sladekdavid1-rgb/cnc-pendant-ugs-rp2040/00_obrazky/DPS_A_rozmisteni.png

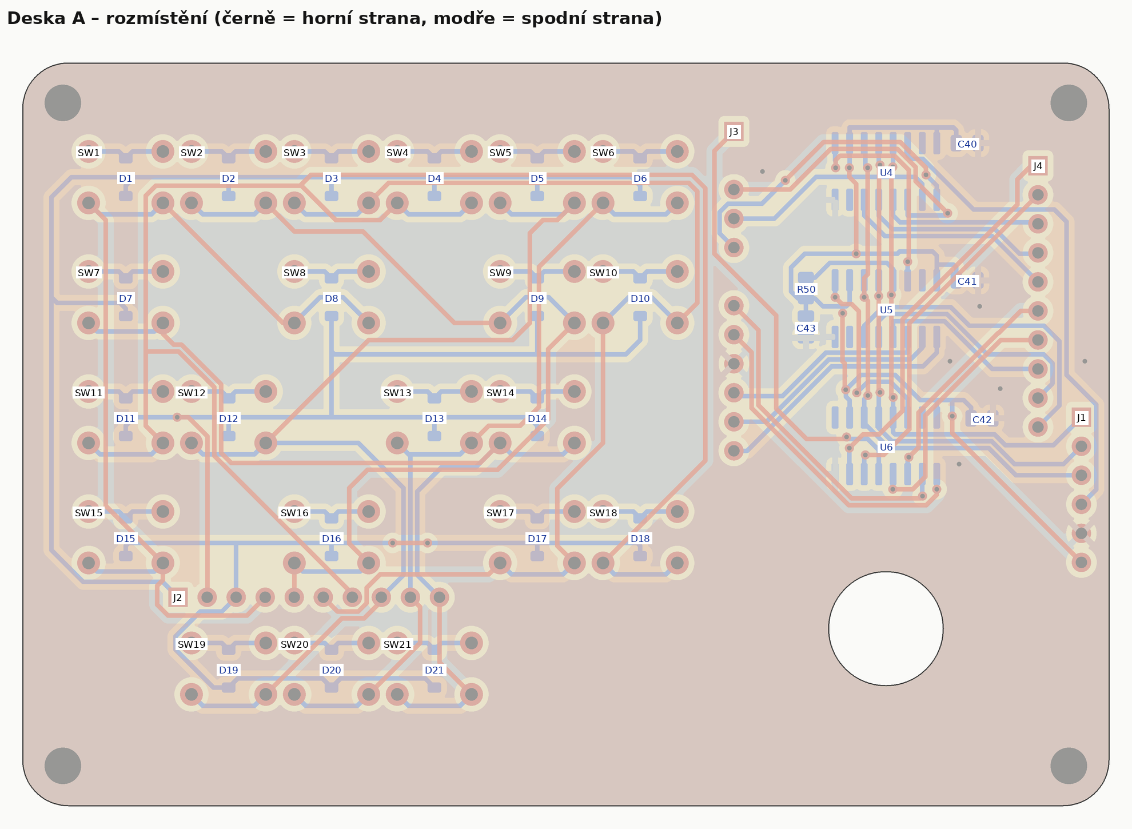
00_obrazky/DPS_A_rozmisteni.png
