sladekdavid1-rgb/cnc-pendant-ugs-rp2040/00_obrazky/DPS_A_spodni_med.png

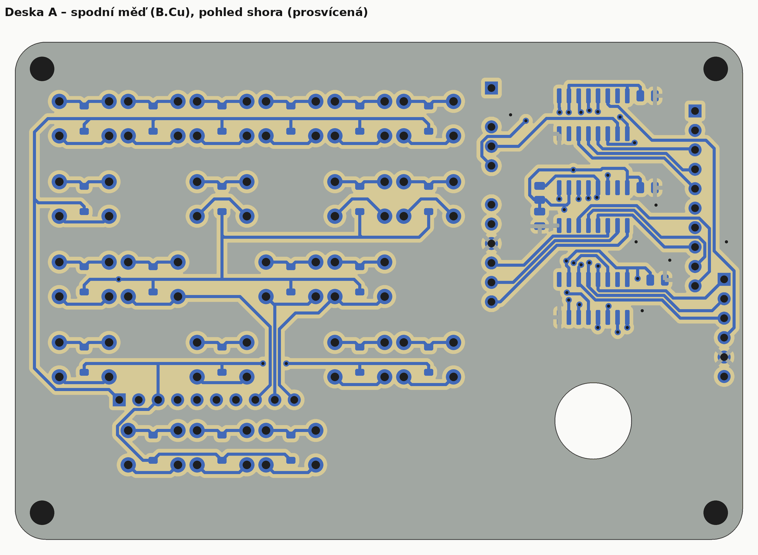
00_obrazky/DPS_A_spodni_med.png
