sladekdavid1-rgb/cnc-pendant-ugs-rp2040/00_obrazky/DPS_B_rozmisteni.png

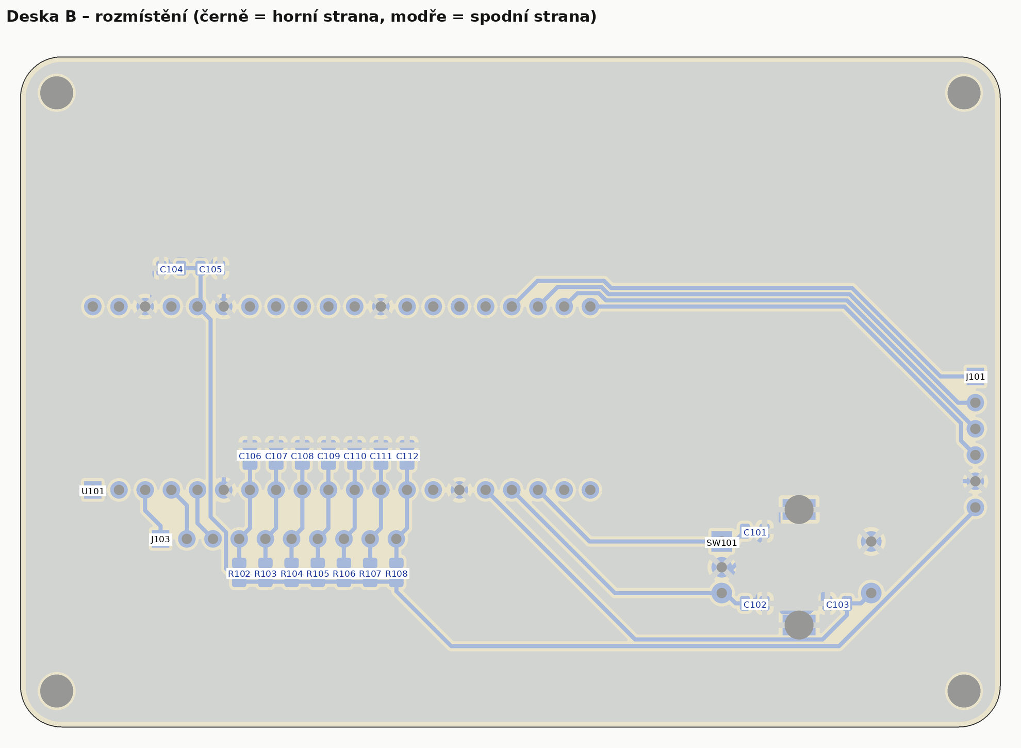
00_obrazky/DPS_B_rozmisteni.png
