sladekdavid1-rgb/cnc-pendant-ugs-rp2040/00_obrazky/fotky/foto_deska_A_spodni.jpg

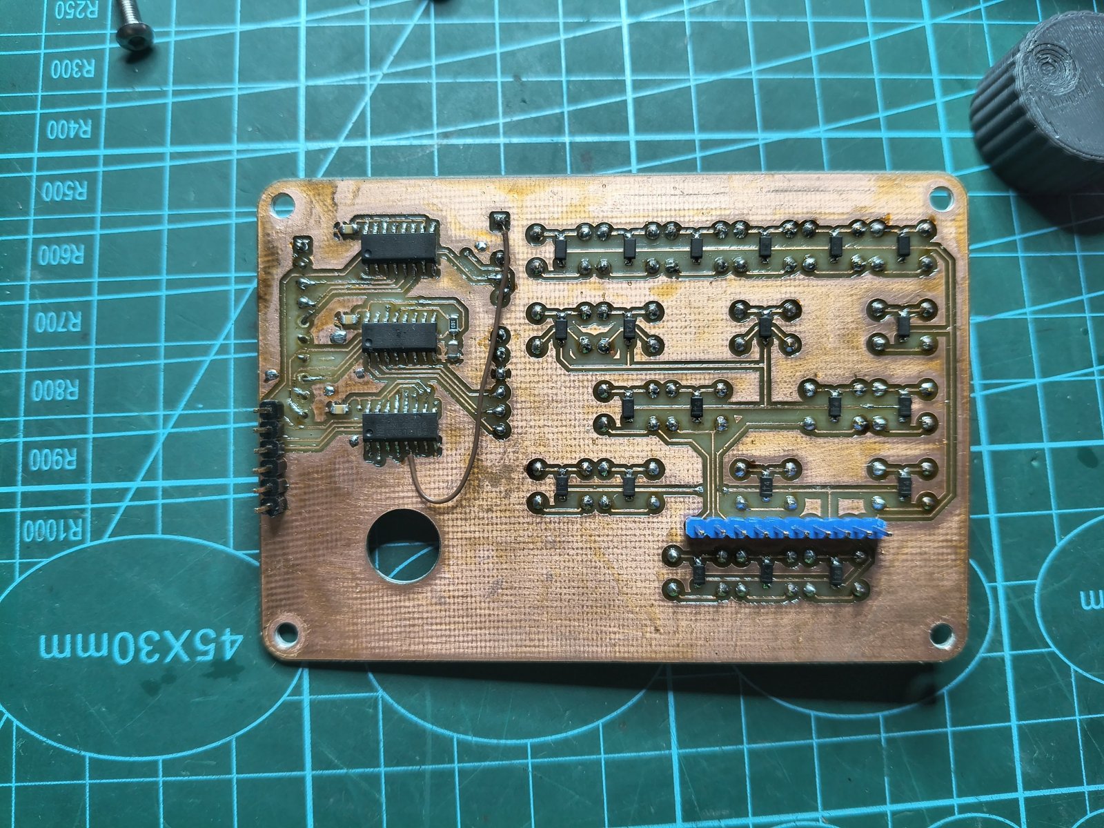
00_obrazky/fotky/foto_deska_A_spodni.jpg
