sladekdavid1-rgb/cnc-pendant-ugs-rp2040/00_obrazky/fotky/foto_hotovy_pendant_sikmo.jpg

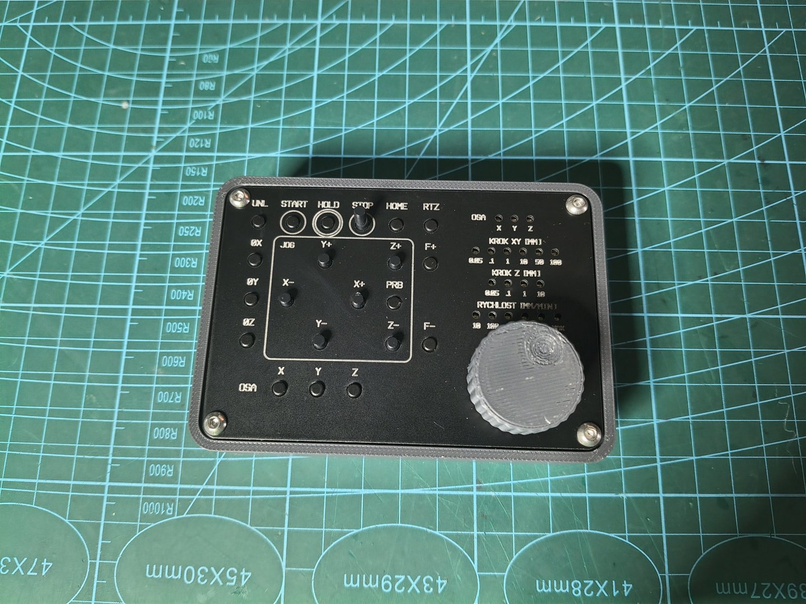
00_obrazky/fotky/foto_hotovy_pendant_sikmo.jpg
