sladekdavid1-rgb/cnc-pendant-ugs-rp2040/00_obrazky/sestava_rez.png

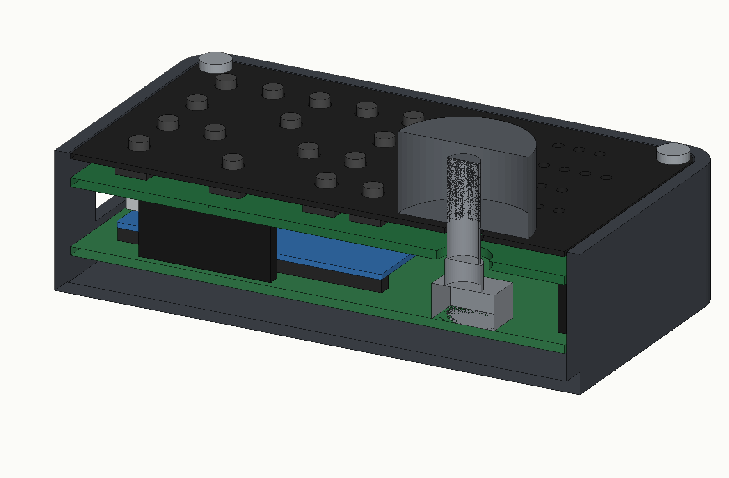
00_obrazky/sestava_rez.png
