sladekdavid1-rgb/cnc-pendant-ugs-rp2040/03_pripravek_MDF/pripravek_DPS_3018.png

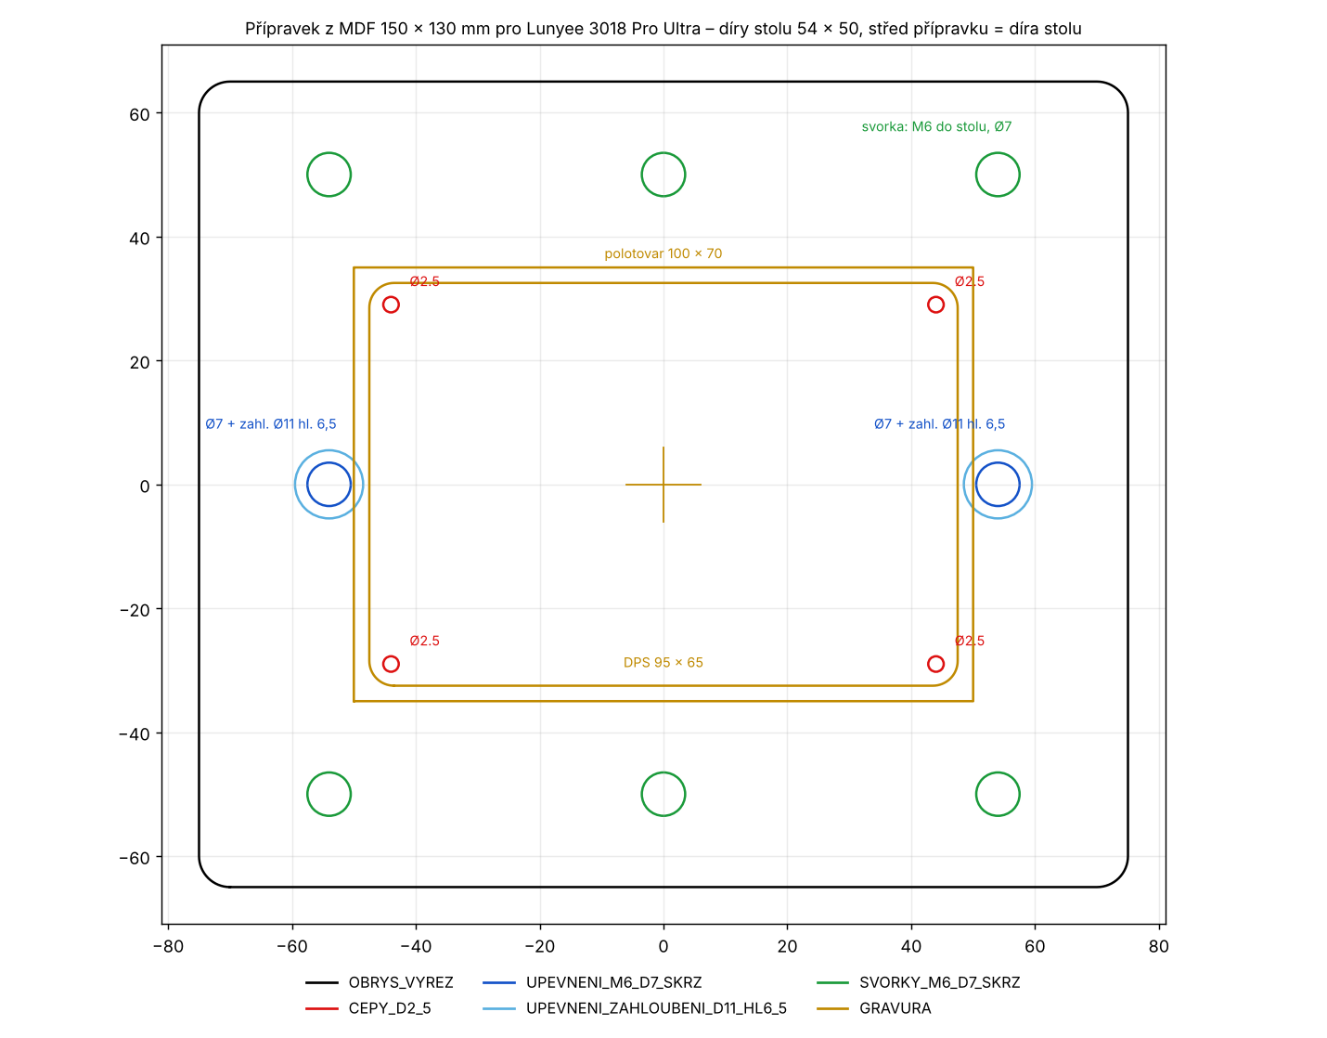
03_pripravek_MDF/pripravek_DPS_3018.png
