sladekdavid1-rgb/cnc-pendant-ugs-rp2040/04_panel_cela/2_laser_paleni/G-kody_bez_LightBurnu/pendant_panel_laser.png

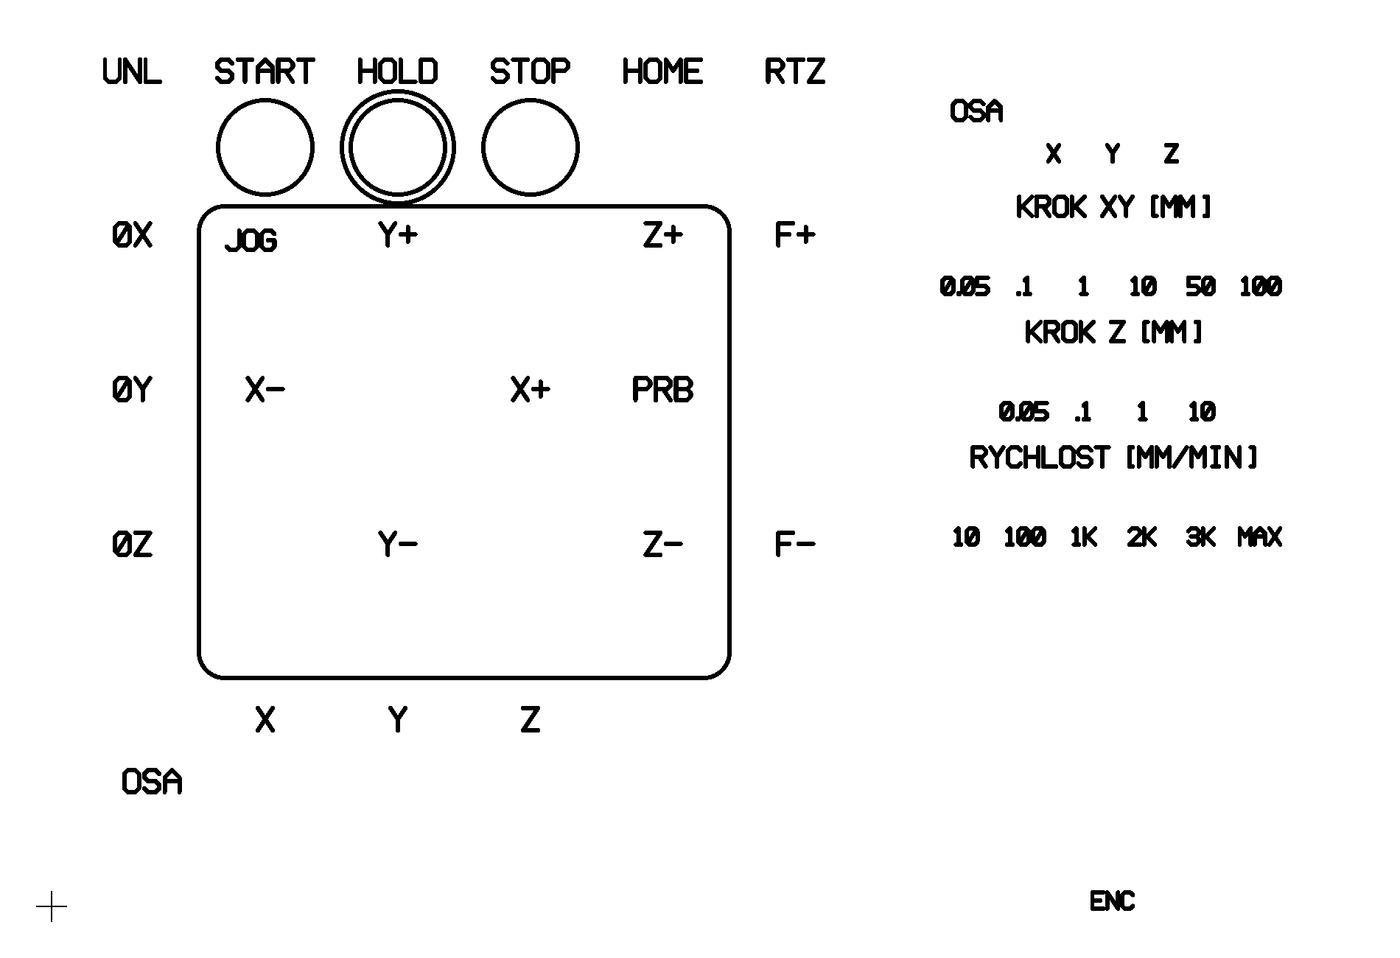
04_panel_cela/2_laser_paleni/G-kody_bez_LightBurnu/pendant_panel_laser.png
