sladekdavid1-rgb/cnc-pendant-ugs-rp2040/04_panel_cela/2_laser_paleni/podklad_nahled.png

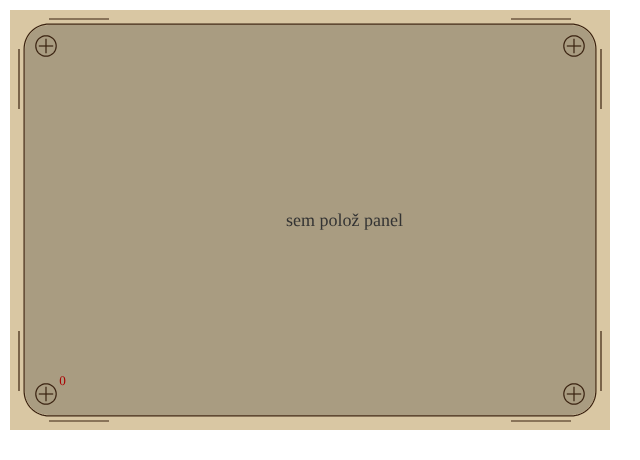
04_panel_cela/2_laser_paleni/podklad_nahled.png
