sladekdavid1-rgb/cnc-pendant-ugs-rp2040/04_panel_cela/3_alternativa_MDF_kapsa/kapsa_panel_MDF_nahled.png

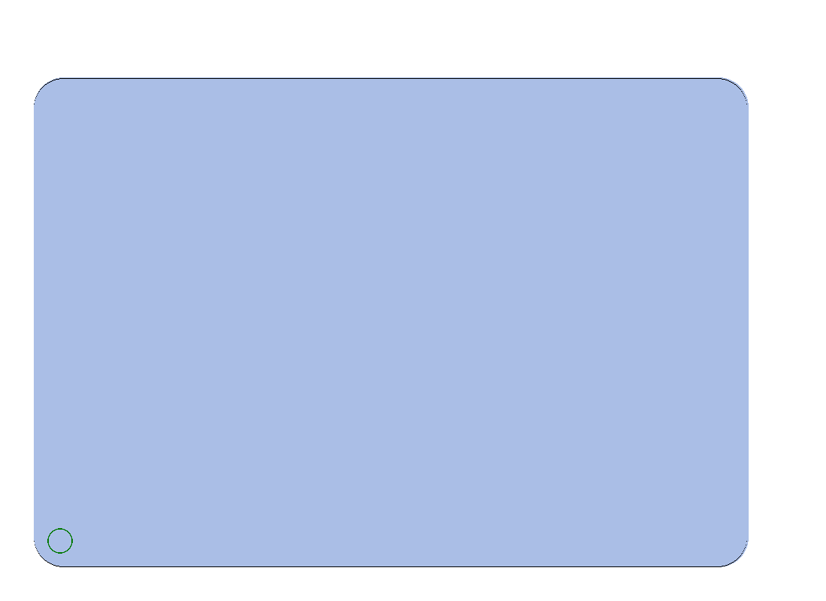
04_panel_cela/3_alternativa_MDF_kapsa/kapsa_panel_MDF_nahled.png
