sladekdavid1-rgb/cnc-pendant-ugs-rp2040/05_krabicka_3D_tisk/knoflik/knoflik_nahled.png

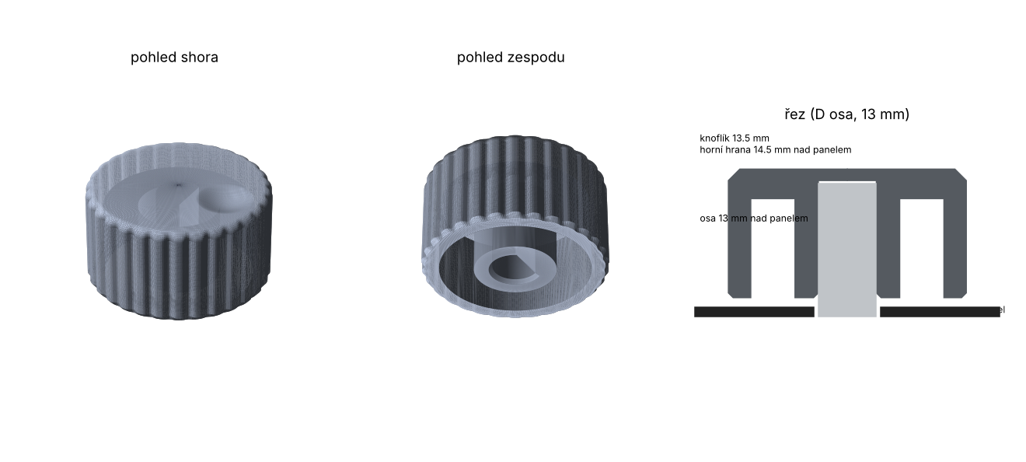
05_krabicka_3D_tisk/knoflik/knoflik_nahled.png
