sladekdavid1-rgb/cnc-pendant-ugs-rp2040/03_pripravek_MDF/pripravek_DPS_3018.dxf

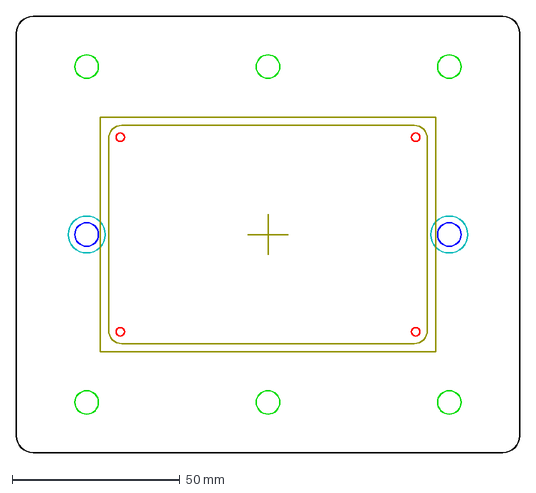
[picture p35: CAD file, 2026-10-19]
03_pripravek_MDF/pripravek_DPS_3018.dxf
150.0 x 130.0 mm
