sladekdavid1-rgb/cnc-pendant-ugs-rp2040/04_panel_cela/vykresy_DXF/pendant_panel_otvory.dxf

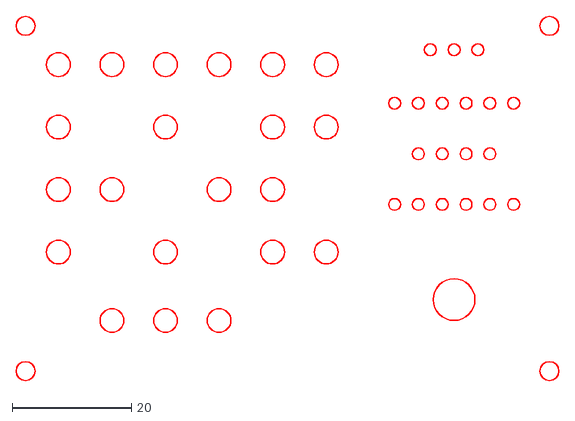
[picture p36: CAD file, 2026-10-19]
04_panel_cela/vykresy_DXF/pendant_panel_otvory.dxf
91.2 x 61.2
