sladekdavid1-rgb/cnc-pendant-ugs-rp2040/05_krabicka_3D_tisk/CNCpendant.step

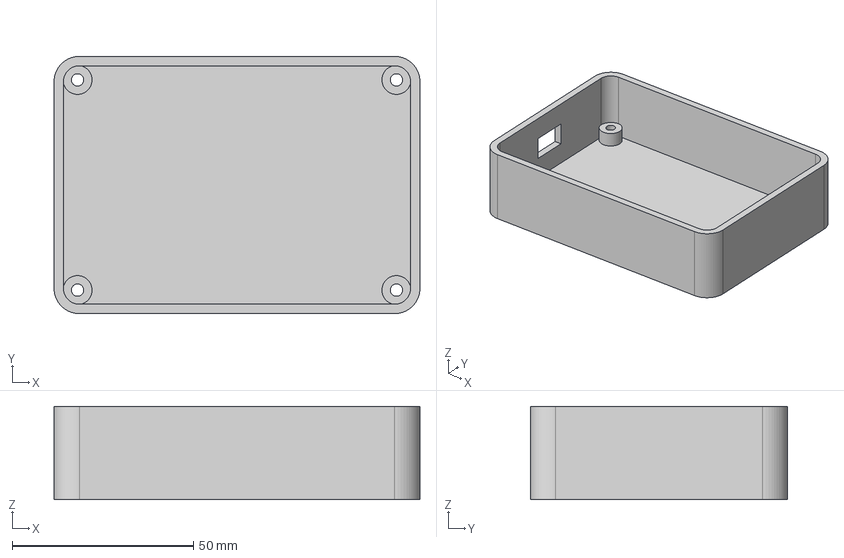
[picture p37: CAD file, 2026-10-19]
05_krabicka_3D_tisk/CNCpendant.step
101.0 x 71.0 x 25.7 mm
