sladekdavid1-rgb/cnc-pendant-ugs-rp2040/05_krabicka_3D_tisk/distancni_sloupky/distance_A-panel_3_5mm.stl

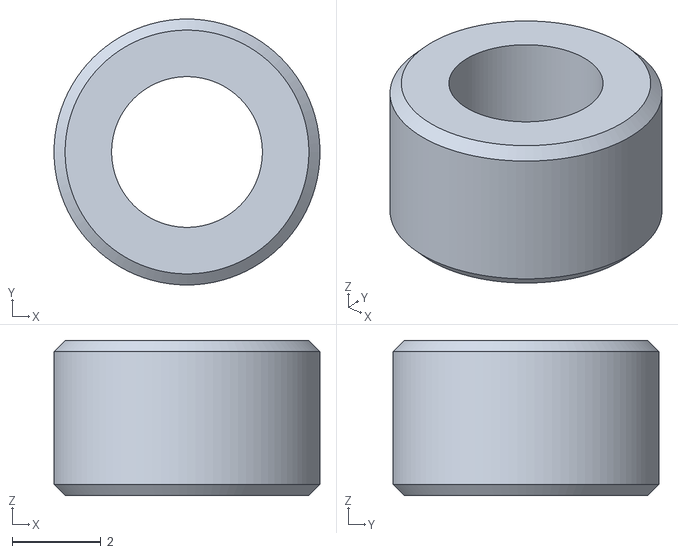
[picture p38: CAD file, 2026-10-19]
05_krabicka_3D_tisk/distancni_sloupky/distance_A-panel_3_5mm.stl
6.00 x 6.00 x 3.50
