sladekdavid1-rgb/cnc-pendant-ugs-rp2040/05_krabicka_3D_tisk/distancni_sloupky/distance_sada_5+5ks.stl

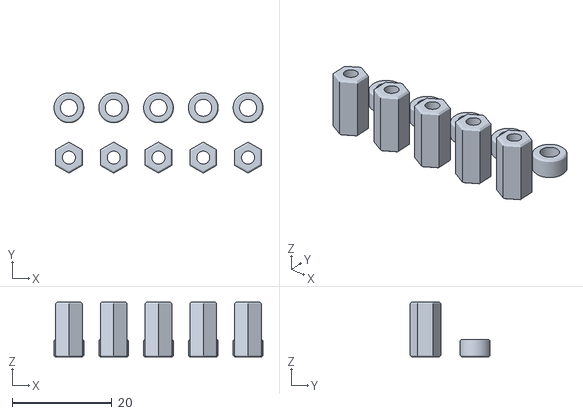
[picture p41: CAD file, 2026-10-19]
05_krabicka_3D_tisk/distancni_sloupky/distance_sada_5+5ks.stl
42.0 x 16.1 x 11.0
