sladekdavid1-rgb/cnc-pendant-ugs-rp2040/05_krabicka_3D_tisk/knoflik/knoflik_vroubkovana_osa_12mm_nad_panelem.stl

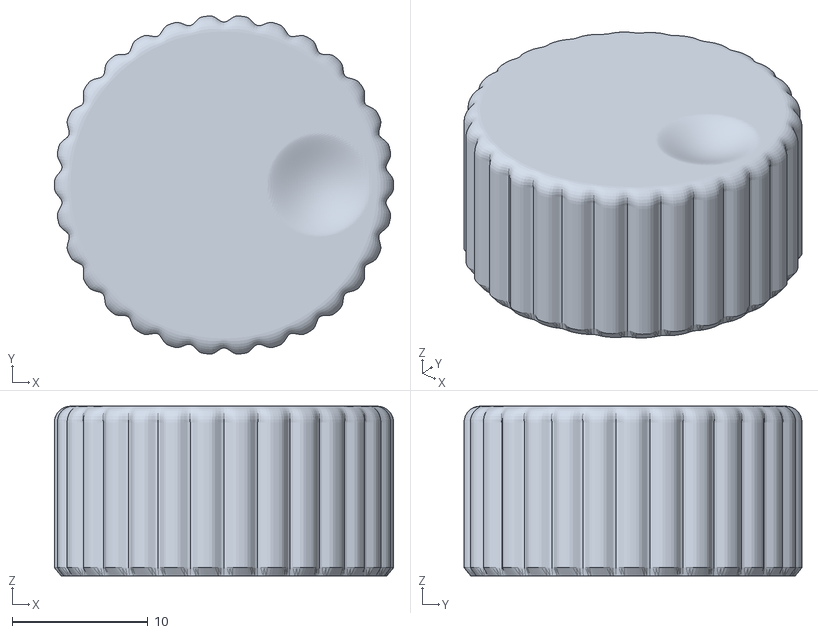
[picture p42: CAD file, 2026-10-19]
05_krabicka_3D_tisk/knoflik/knoflik_vroubkovana_osa_12mm_nad_panelem.stl
25.0 x 24.9 x 12.5
