sladekdavid1-rgb/cnc-pendant-ugs-rp2040/04_panel_cela/vykresy_DXF/pendant_panel_obrys.dxf

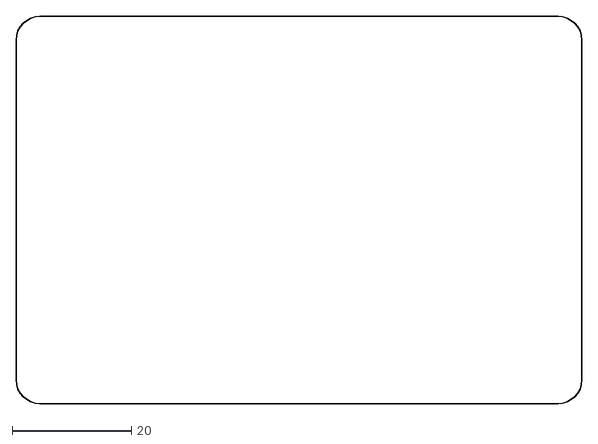
[picture p43: CAD file, 2026-10-19]
04_panel_cela/vykresy_DXF/pendant_panel_obrys.dxf
95.0 x 65.0
