sladekdavid1-rgb/cnc-pendant-ugs-rp2040/05_krabicka_3D_tisk/distancni_sloupky/distance_B-A_11mm_SESTIHRAN_5_5.stl

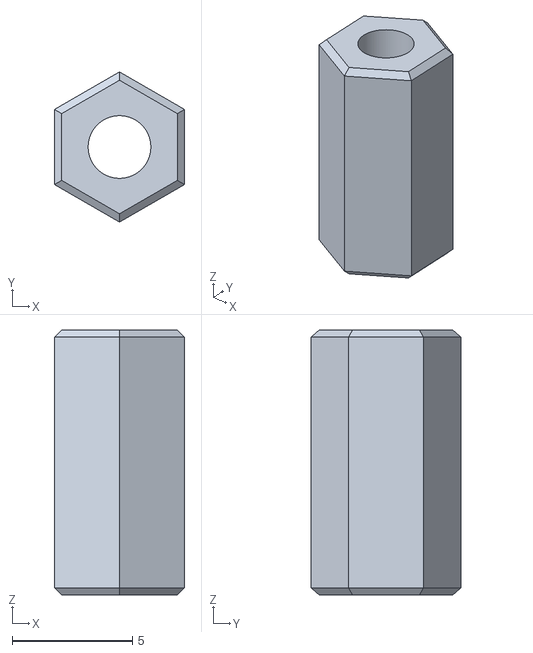
[picture p44: CAD file, 2026-10-19]
05_krabicka_3D_tisk/distancni_sloupky/distance_B-A_11mm_SESTIHRAN_5_5.stl
5.40 x 6.24 x 11.0
