sladekdavid1-rgb/cnc-pendant-ugs-rp2040/04_panel_cela/vykresy_DXF/pendant_panel_gravura.dxf

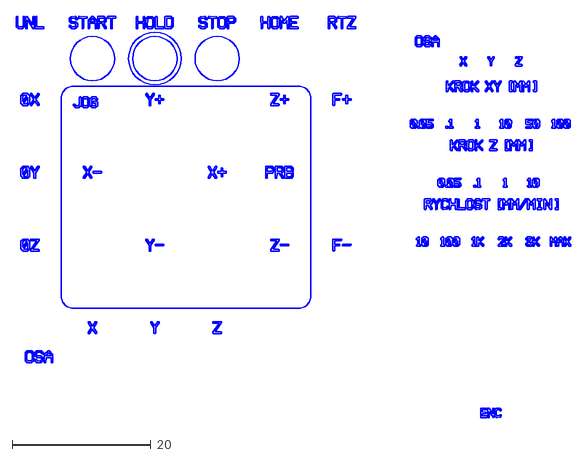
[picture p46: CAD file, 2026-10-19]
04_panel_cela/vykresy_DXF/pendant_panel_gravura.dxf
80.0 x 57.9
