sladekdavid1-rgb/cnc-pendant-ugs-rp2040/(list of files, cad)

Other CAD files:
05_krabicka_3D_tisk/knoflik/knoflik_vroubkovana_osa_9mm_nad_panelem.stl
05_krabicka_3D_tisk/knoflik/knoflik_D_osa_13mm_nad_panelem.stl
05_krabicka_3D_tisk/knoflik/knoflik_D_osa_12mm_nad_panelem.stl
05_krabicka_3D_tisk/knoflik/knoflik_vroubkovana_osa_14mm_nad_panelem.stl
05_krabicka_3D_tisk/knoflik/knoflik_D_osa_10mm_nad_panelem.stl
05_krabicka_3D_tisk/knoflik/knoflik_D_osa_11mm_nad_panelem.stl
05_krabicka_3D_tisk/CNCpendant.3mf
