sladekdavid1-rgb/cnc-pendant-ugs-rp2040/01_DPS_KiCad/pendant_B_spodni/pendant_B_spodni.kicad_pcb

## KiCad design 01_DPS_KiCad/pendant_B_spodni/pendant_B_spodni.kicad_pcb (2026-10-19)

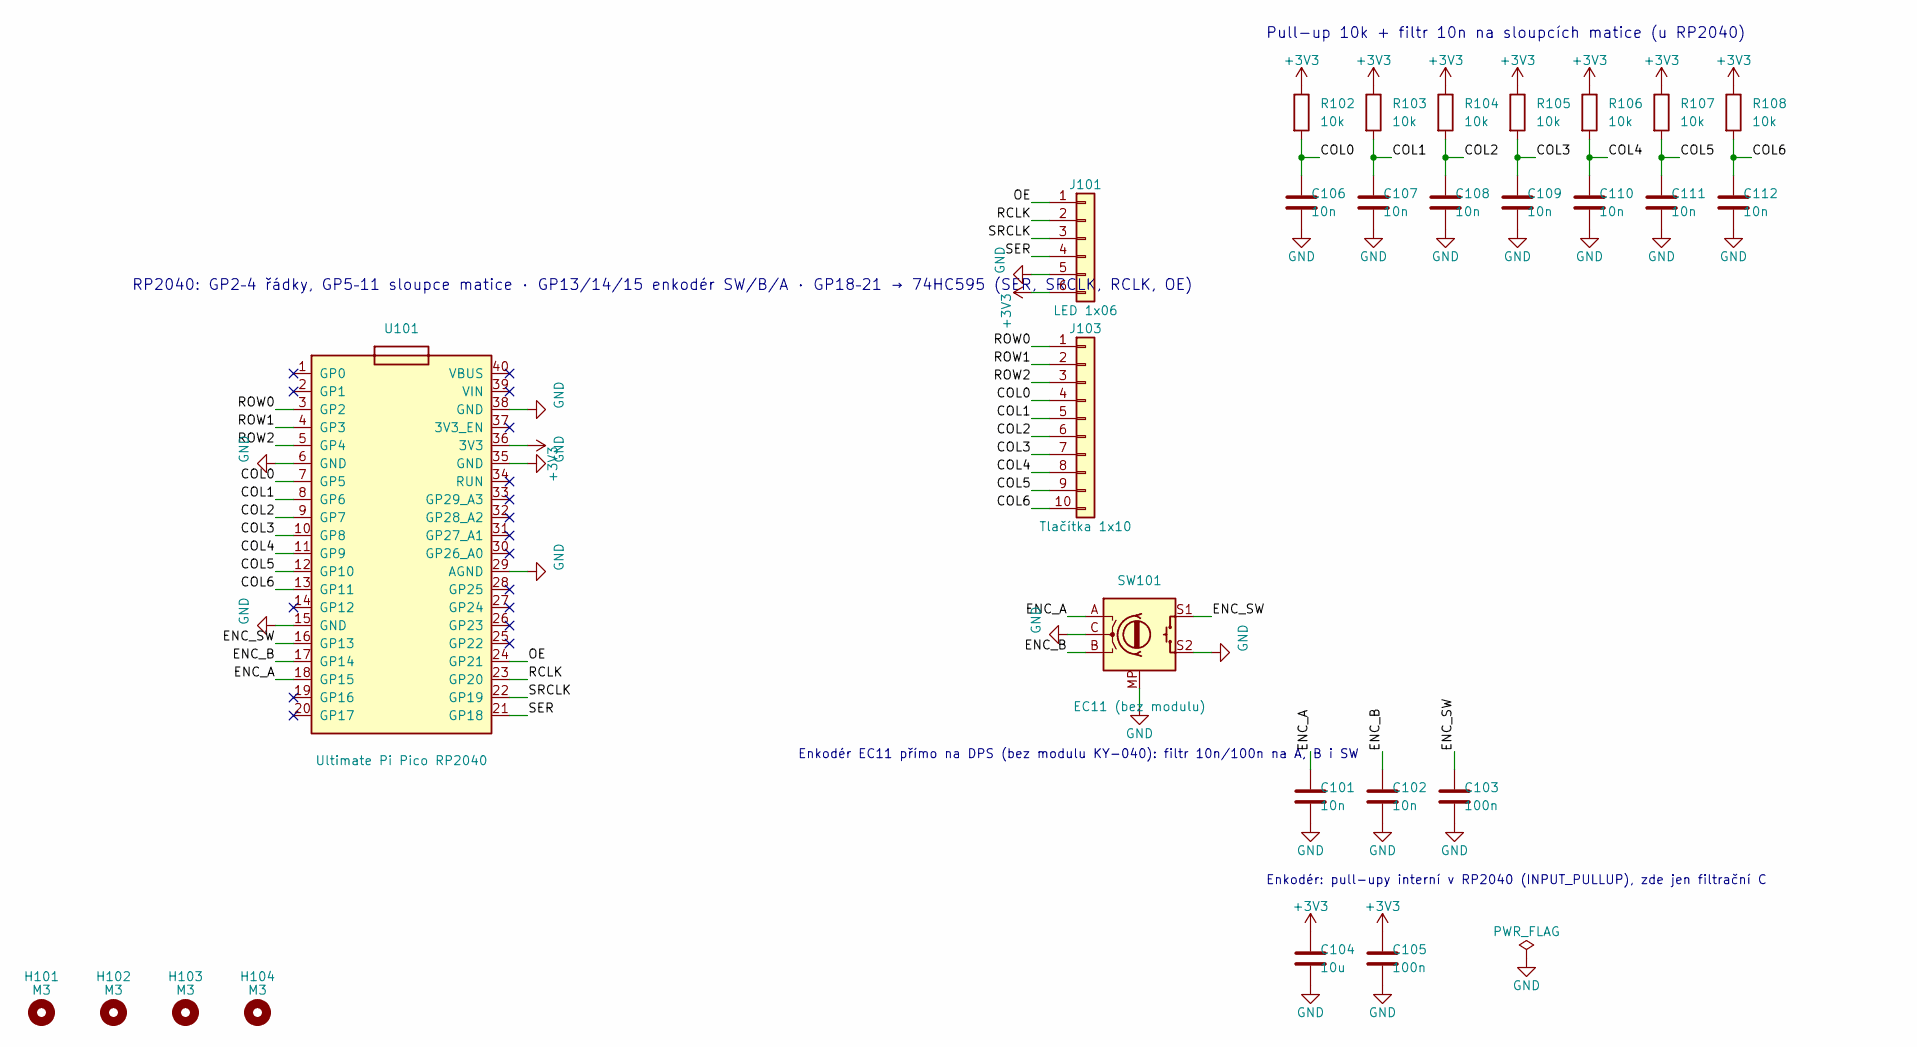
[picture p51: schematic pendant_B_spodni.kicad_sch, CNC pendant – spodní DPS (Ultimate Pi Pico RP2040, enkodér)]

Parts:
C101, C102, C106, C107, C108, C109, C110, C111, C112: 10n; C_0805_2012Metric
C103, C105: 100n; C_0805_2012Metric
C104: 10u; C_0805_2012Metric
H101, H102, H103, H104: M3; MountingHole_3.2mm_M3
J101: LED 1x06; PinHeader_1x06_P2.54mm_Vertical
J103: Tlačítka 1x10; PinHeader_1x10_P2.54mm_Vertical
R102, R103, R104, R105, R106, R107, R108: 10k; R_0805_2012Metric
SW101: EC11 (bez modulu); RotaryEncoder_Alps_EC11E-Switch_Vertical_H20mm
U101: Ultimate Pi Pico RP2040; Ultimate_Pico_2x20_W17.78

Connections:
+3V3: C104.1, C105.1, J101.6, R102.1, R103.1, R104.1, R105.1, R106.1, R107.1, R108.1, U101.36 (3V3)
/COL0: C106.1, J103.4, R102.2, U101.7 (GP5)
/COL1: C107.1, J103.5, R103.2, U101.8 (GP6)
/COL2: C108.1, J103.6, R104.2, U101.9 (GP7)
/COL3: C109.1, J103.7, R105.2, U101.10 (GP8)
/COL4: C110.1, J103.8, R106.2, U101.11 (GP9)
/COL5: C111.1, J103.9, R107.2, U101.12 (GP10)
/COL6: C112.1, J103.10, R108.2, U101.13 (GP11)
/ENC_A: C101.1, SW101.A, U101.18 (GP15)
/ENC_B: C102.1, SW101.B, U101.17 (GP14)
/ENC_SW: C103.1, SW101.S1, U101.16 (GP13)
/OE: J101.1, U101.24 (GP21)
/RCLK: J101.2, U101.23 (GP20)
/ROW0: J103.1, U101.3 (GP2)
/ROW1: J103.2, U101.4 (GP3)
/ROW2: J103.3, U101.5 (GP4)
/SER: J101.4, U101.21 (GP18)
/SRCLK: J101.3, U101.22 (GP19)
GND: C101.2, C102.2, C103.2, C104.2, C105.2, C106.2, C107.2, C108.2, C109.2, C110.2, C111.2, C112.2, J101.5, SW101.C, SW101.MP, SW101.S2, U101.6 (GND), U101.15 (GND), U101.29 (AGND), U101.35 (GND), U101.38 (GND)

Notes on the sheet:
RP2040: GP2–4 řádky, GP5–11 sloupce matice · GP13/14/15 enkodér SW/B/A · GP18–21 → 74HC595 (SER, SRCLK, RCLK, OE)
Pull-up 10k + filtr 10n na sloupcích matice (u RP2040)
Enkodér EC11 přímo na DPS (bez modulu KY-040): filtr 10n/100n na A, B i SW
Enkodér: pull-upy interní v RP2040 (INPUT_PULLUP), zde jen filtrační C

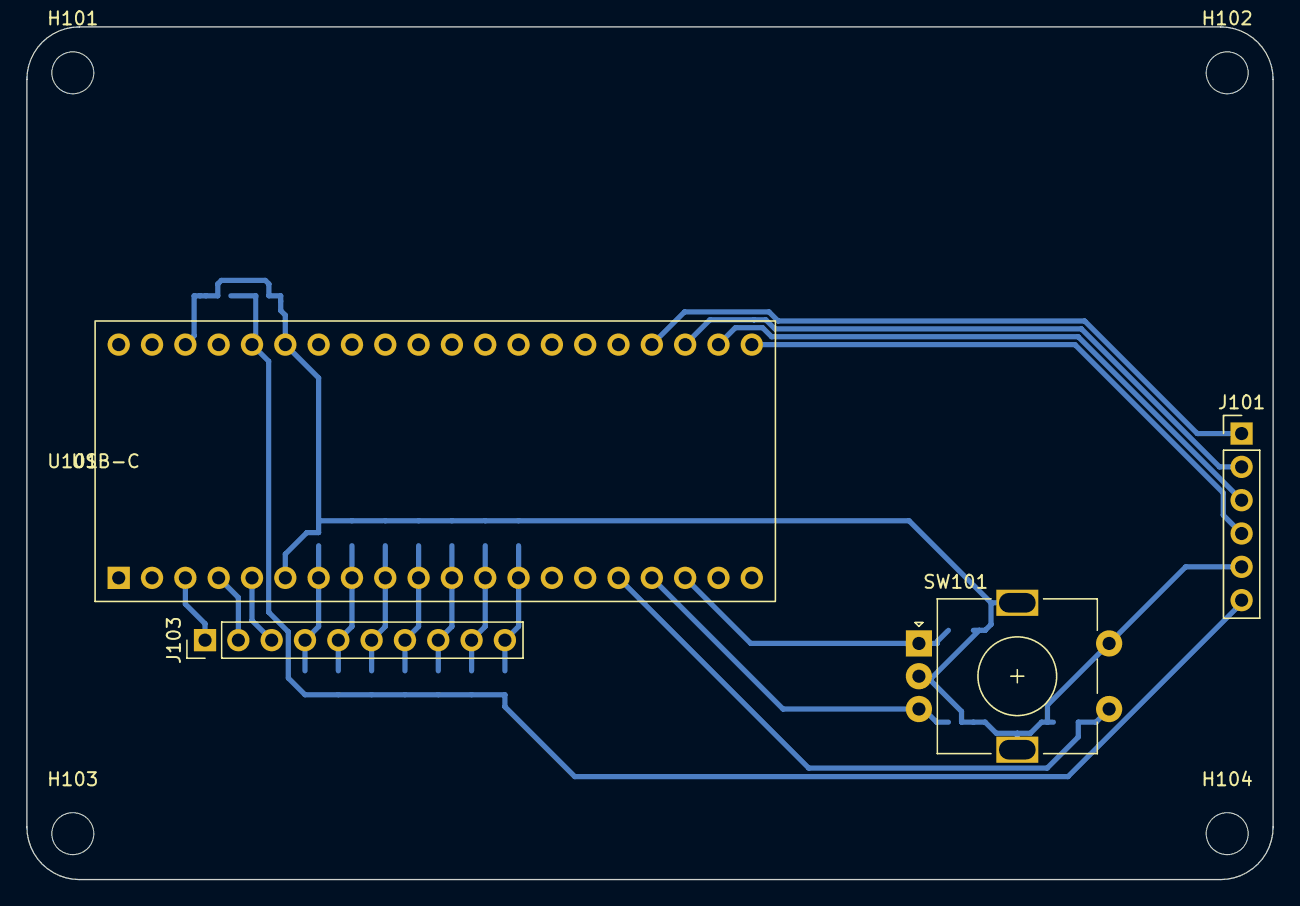
[picture p52: board pendant_B_spodni.kicad_pcb from above]

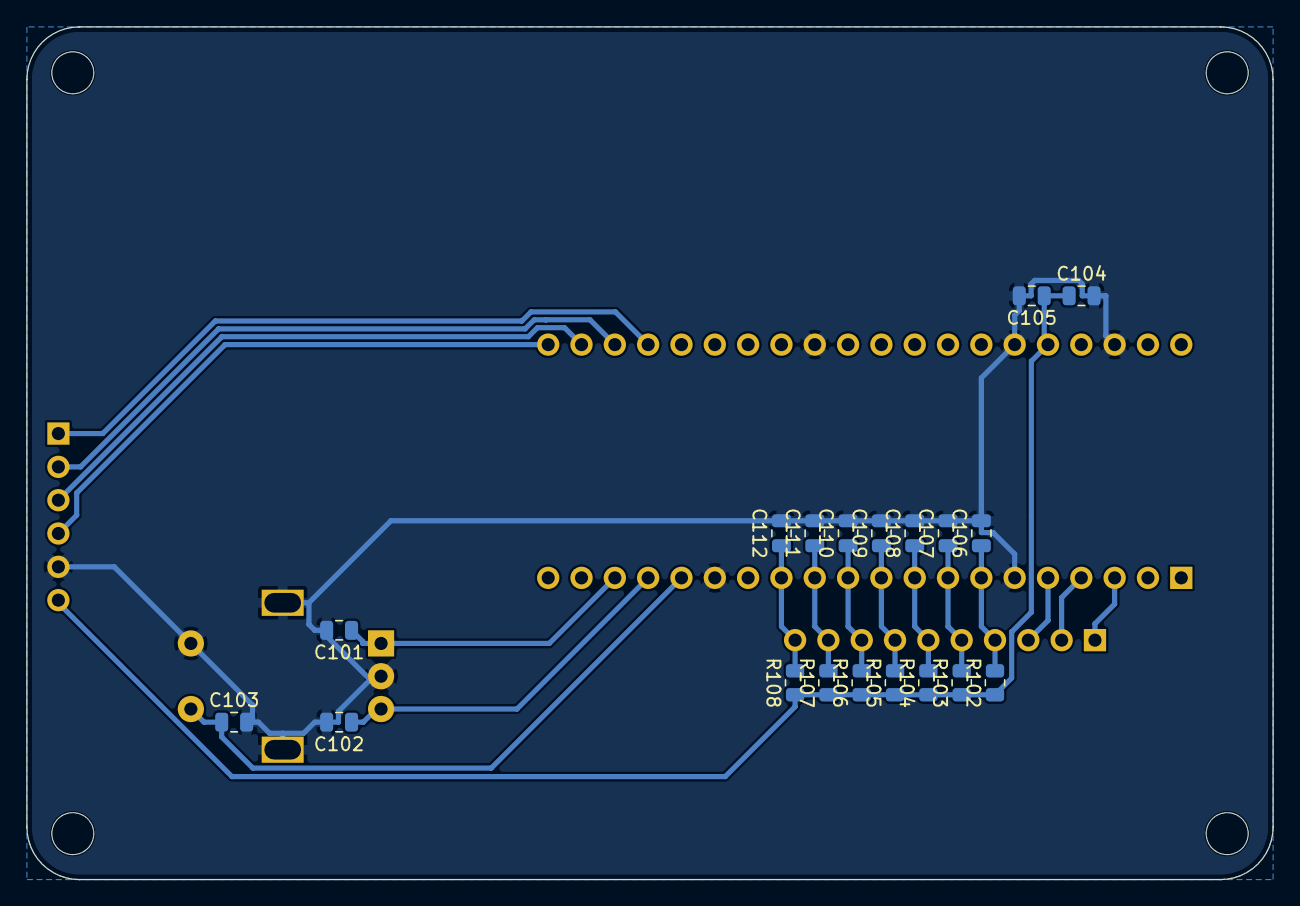
[picture p53: board pendant_B_spodni.kicad_pcb from below]

Board: 2 copper layers, 95.0 x 65.0 mm, 27 parts (19 on the bottom side), 19 nets.
