sladekdavid1-rgb/cnc-pendant-ugs-rp2040/01_DPS_KiCad/pendant_A_horni/pendant_A_horni.kicad_pcb

## KiCad design 01_DPS_KiCad/pendant_A_horni/pendant_A_horni.kicad_pcb (2026-10-19)

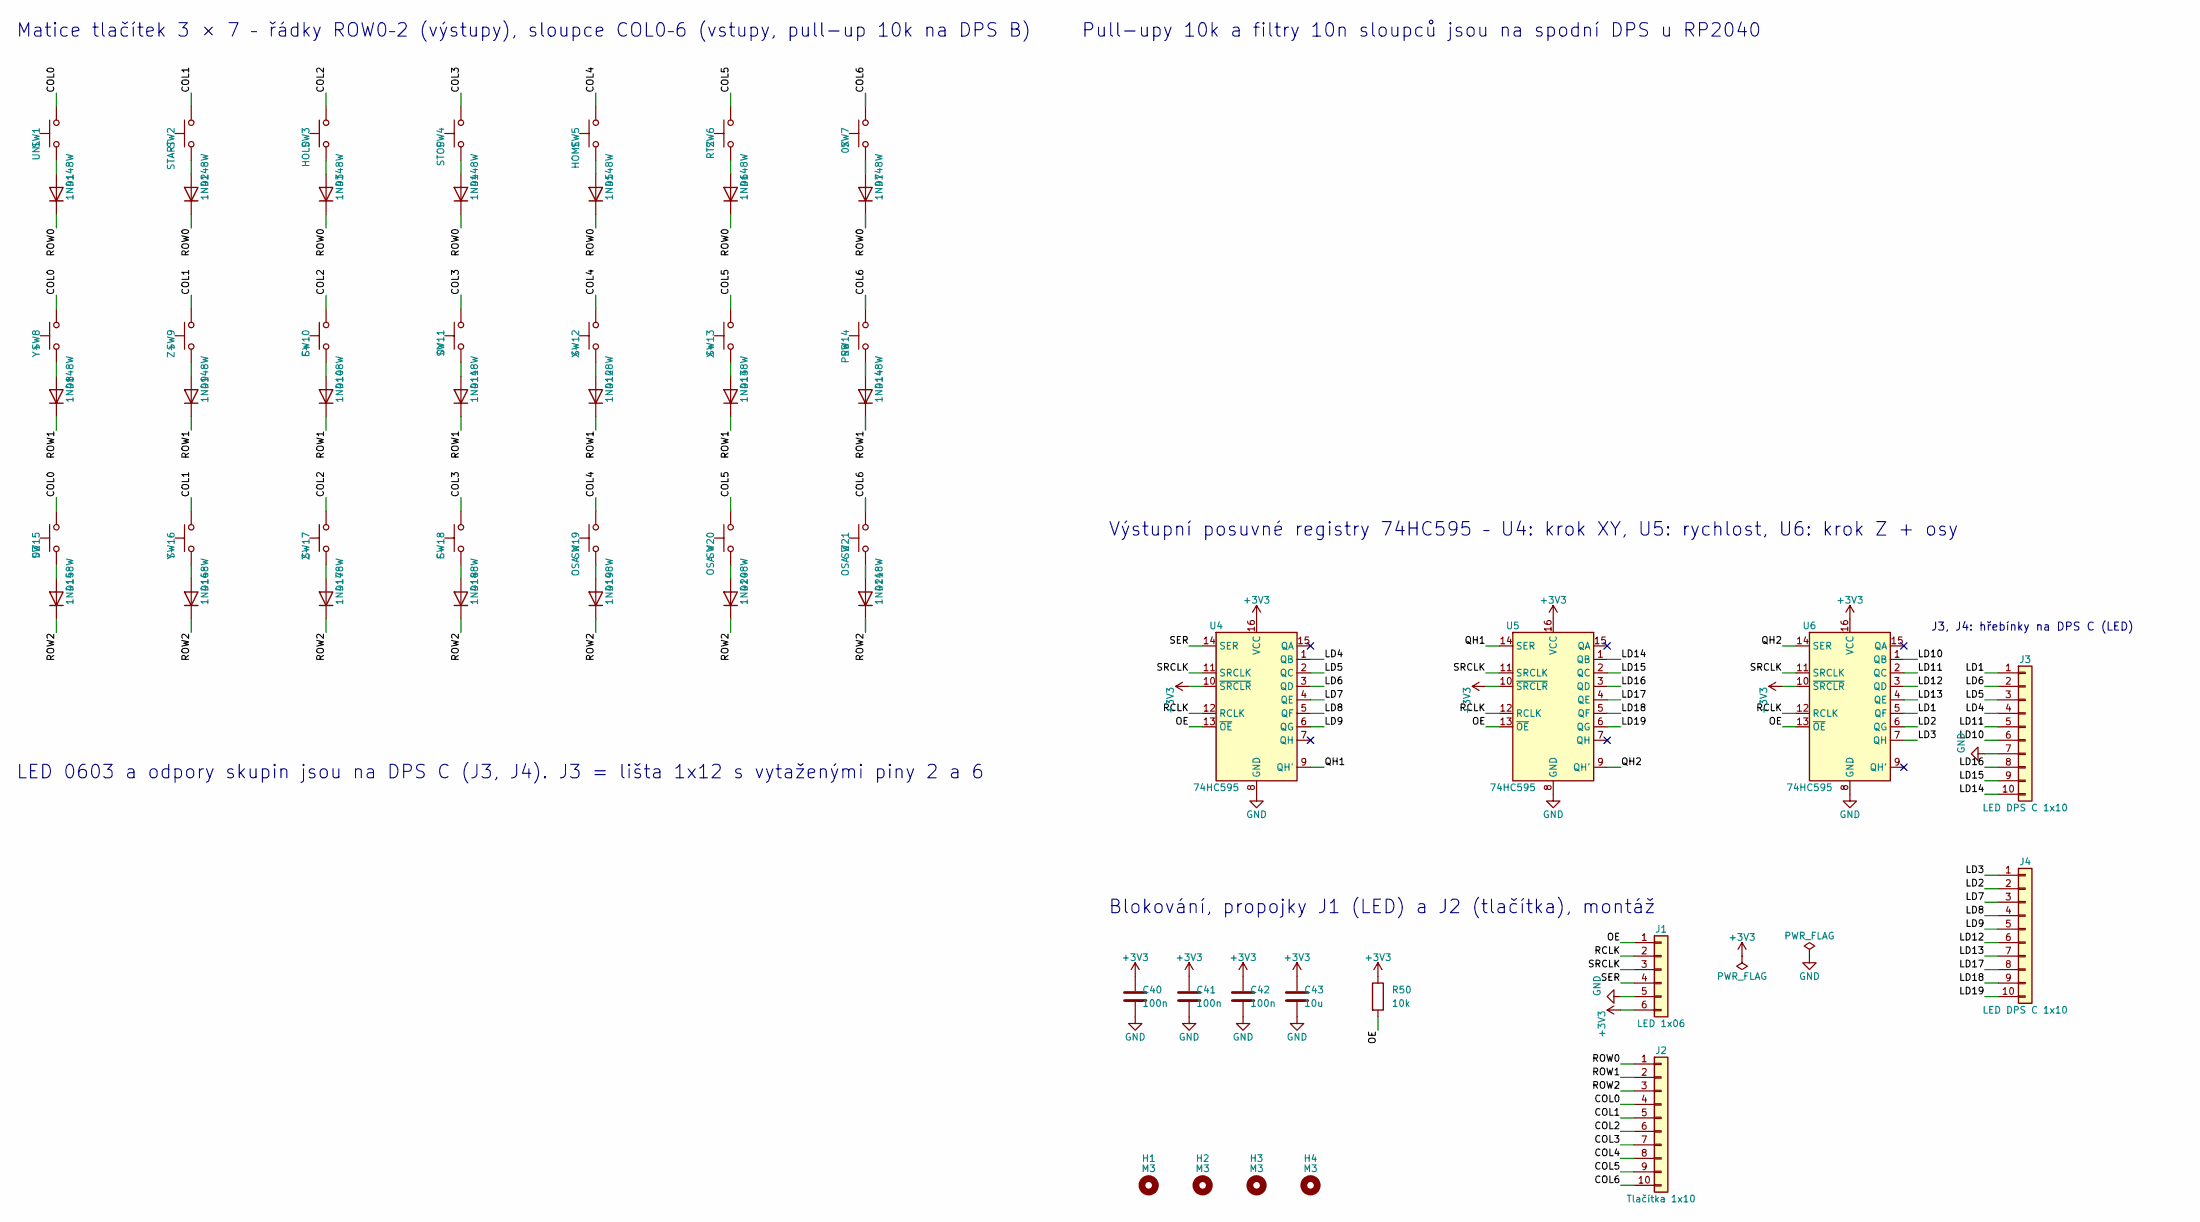
[picture p54: schematic pendant_A_horni.kicad_sch, CNC pendant – horní DPS (matice tlačítek, LED, 74HC595)]

Parts:
C40, C41, C42: 100n; C_0805_2012Metric
C43: 10u; C_0805_2012Metric
D1, D2, D3, D4, D5, D6, D7, D8, D9, D10, D11, D12, D13, D14, D15, D16, D17, D18, D19, D20, D21: 1N4148W; D_SOD-123
H1, H2, H3, H4: M3; MountingHole_3.2mm_M3
J1: LED 1x06; PinHeader_1x06_P2.54mm_Vertical
J2: Tlačítka 1x10; PinHeader_1x10_P2.54mm_Vertical
J3: LED DPS C 1x10; PinHeader_1x12_P2.54mm_10pinu
J4: LED DPS C 1x10; PinHeader_1x10_P2.54mm_Vertical
R50: 10k; R_0805_2012Metric
SW1: UNL; SW_PUSH_6mm
SW2: START; SW_PUSH_6mm
SW3: HOLD; SW_PUSH_6mm
SW4: STOP; SW_PUSH_6mm
SW5: HOME; SW_PUSH_6mm
SW6: RTZ; SW_PUSH_6mm
SW7: 0X; SW_PUSH_6mm
SW8: Y+; SW_PUSH_6mm
SW9: Z+; SW_PUSH_6mm
SW10: F+; SW_PUSH_6mm
SW11: 0Y; SW_PUSH_6mm
SW12: X-; SW_PUSH_6mm
SW13: X+; SW_PUSH_6mm
SW14: PRB; SW_PUSH_6mm
SW15: 0Z; SW_PUSH_6mm
SW16: Y-; SW_PUSH_6mm
SW17: Z-; SW_PUSH_6mm
SW18: F-; SW_PUSH_6mm
SW19: OSA X; SW_PUSH_6mm
SW20: OSA Y; SW_PUSH_6mm
SW21: OSA Z; SW_PUSH_6mm
U4, U5, U6: 74HC595; SOIC-16_3.9x9.9mm_P1.27mm

Connections:
+3V3: C40.1, C41.1, C42.1, C43.1, J1.6, R50.1, U4.10 (~SRCLR), U4.16 (VCC), U5.10 (~SRCLR), U5.16 (VCC), U6.10 (~SRCLR), U6.16 (VCC)
/COL0: J2.4, SW1.2, SW8.2, SW15.2
/COL1: J2.5, SW2.2, SW9.2, SW16.2
/COL2: J2.6, SW3.2, SW10.2, SW17.2
/COL3: J2.7, SW4.2, SW11.2, SW18.2
/COL4: J2.8, SW5.2, SW12.2, SW19.2
/COL5: J2.9, SW6.2, SW13.2, SW20.2
/COL6: J2.10, SW7.2, SW14.2, SW21.2
/LD1: J3.1, U6.5 (QF)
/LD2: J4.2, U6.6 (QG)
/LD3: J4.1, U6.7 (QH)
/LD4: J3.4, U4.1 (QB)
/LD5: J3.3, U4.2 (QC)
/LD6: J3.2, U4.3 (QD)
/LD7: J4.3, U4.4 (QE)
/LD8: J4.4, U4.5 (QF)
/LD9: J4.5, U4.6 (QG)
/LD10: J3.6, U6.1 (QB)
/LD11: J3.5, U6.2 (QC)
/LD12: J4.6, U6.3 (QD)
/LD13: J4.7, U6.4 (QE)
/LD14: J3.10, U5.1 (QB)
/LD15: J3.9, U5.2 (QC)
/LD16: J3.8, U5.3 (QD)
/LD17: J4.8, U5.4 (QE)
/LD18: J4.9, U5.5 (QF)
/LD19: J4.10, U5.6 (QG)
/OE: J1.1, R50.2, U4.13 (~OE), U5.13 (~OE), U6.13 (~OE)
/QH1: U4.9 (QH'), U5.14 (SER)
/QH2: U5.9 (QH'), U6.14 (SER)
/RCLK: J1.2, U4.12 (RCLK), U5.12 (RCLK), U6.12 (RCLK)
/ROW0: D1.1 (K), D2.1 (K), D3.1 (K), D4.1 (K), D5.1 (K), D6.1 (K), D7.1 (K), J2.1
/ROW1: D8.1 (K), D9.1 (K), D10.1 (K), D11.1 (K), D12.1 (K), D13.1 (K), D14.1 (K), J2.2
/ROW2: D15.1 (K), D16.1 (K), D17.1 (K), D18.1 (K), D19.1 (K), D20.1 (K), D21.1 (K), J2.3
/SER: J1.4, U4.14 (SER)
/SRCLK: J1.3, U4.11 (SRCLK), U5.11 (SRCLK), U6.11 (SRCLK)
GND: C40.2, C41.2, C42.2, C43.2, J1.5, J3.7, U4.8 (GND), U5.8 (GND), U6.8 (GND)
unnamed: D1.2 (A), SW1.1
unnamed: D2.2 (A), SW2.1
unnamed: D3.2 (A), SW3.1
unnamed: D4.2 (A), SW4.1
unnamed: D5.2 (A), SW5.1
unnamed: D6.2 (A), SW6.1
unnamed: D7.2 (A), SW7.1
unnamed: D8.2 (A), SW8.1
unnamed: D9.2 (A), SW9.1
unnamed: D10.2 (A), SW10.1
unnamed: D11.2 (A), SW11.1
unnamed: D12.2 (A), SW12.1
unnamed: D13.2 (A), SW13.1
unnamed: D14.2 (A), SW14.1
unnamed: D15.2 (A), SW15.1
unnamed: D16.2 (A), SW16.1
unnamed: D17.2 (A), SW17.1
unnamed: D18.2 (A), SW18.1
unnamed: D19.2 (A), SW19.1
unnamed: D20.2 (A), SW20.1
unnamed: D21.2 (A), SW21.1

Notes on the sheet:
Matice tlačítek 3 × 7 – řádky ROW0–2 (výstupy), sloupce COL0–6 (vstupy, pull-up 10k na DPS B)
Pull-upy 10k a filtry 10n sloupců jsou na spodní DPS u RP2040
Výstupní posuvné registry 74HC595 – U4: krok XY, U5: rychlost, U6: krok Z + osy
LED 0603 a odpory skupin jsou na DPS C (J3, J4). J3 = lišta 1x12 s vytaženými piny 2 a 6
Blokování, propojky J1 (LED) a J2 (tlačítka), montáž
J3, J4: hřebínky na DPS C (LED)

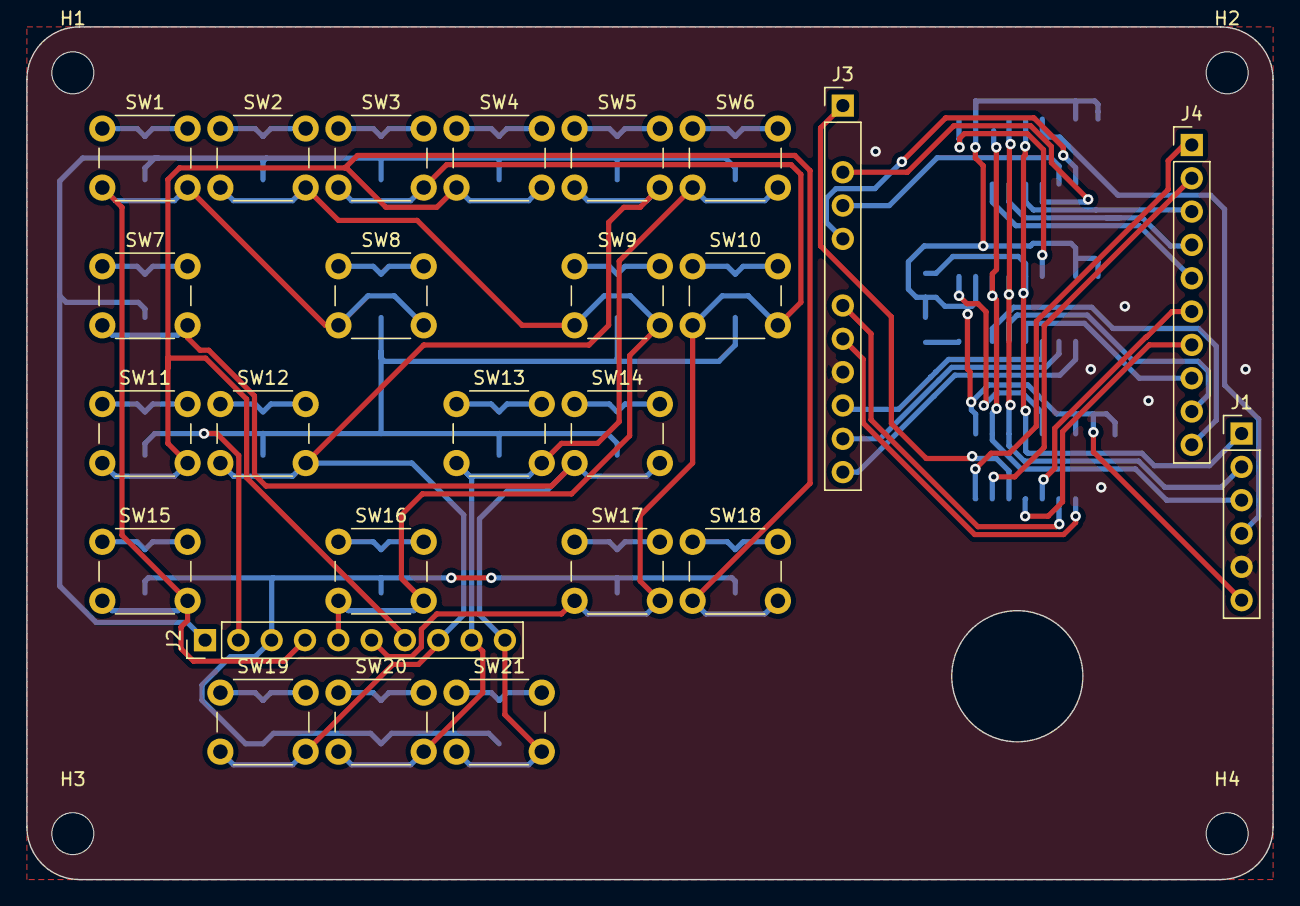
[picture p55: board pendant_A_horni.kicad_pcb from above]

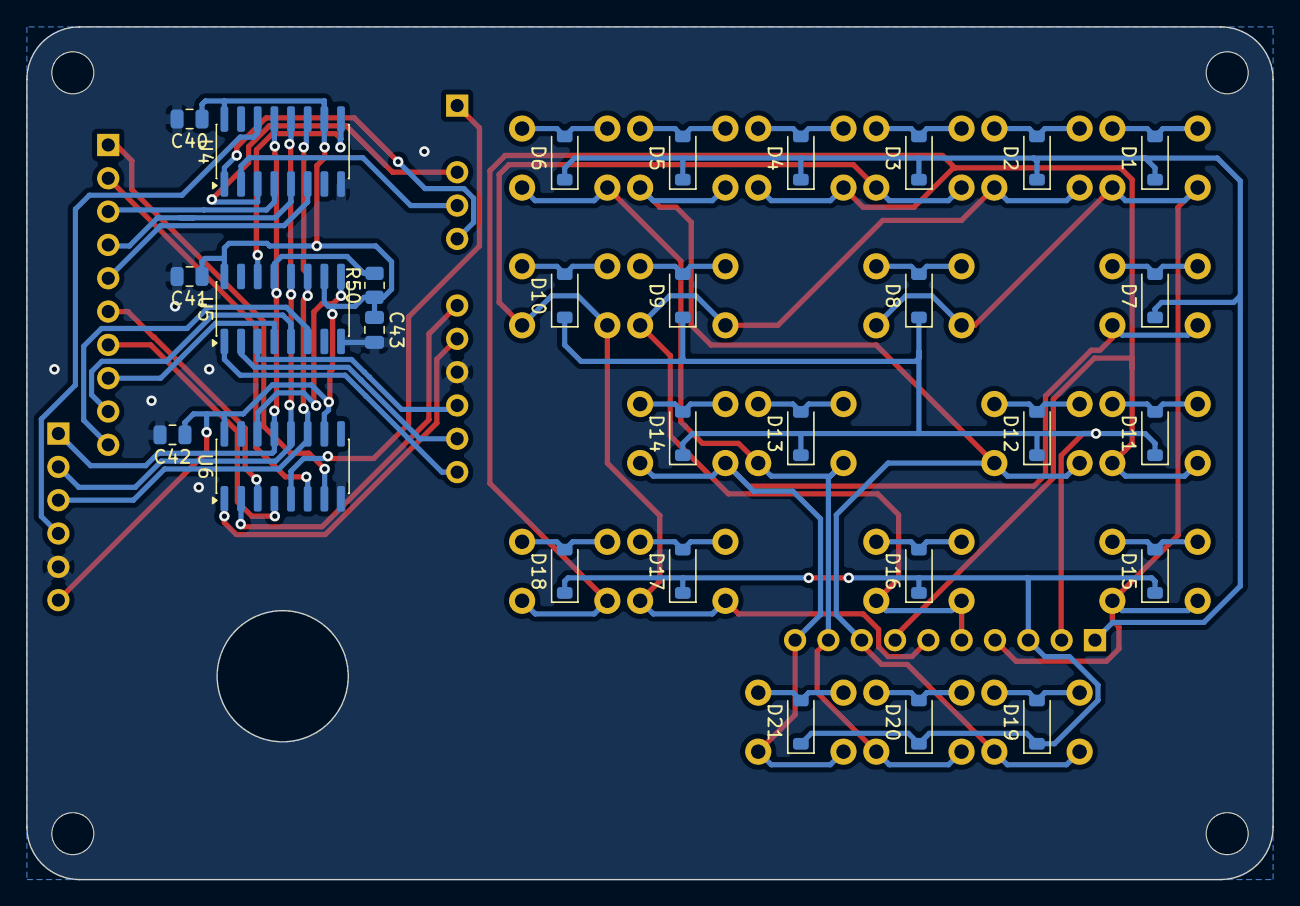
[picture p56: board pendant_A_horni.kicad_pcb from below]

Board: 2 copper layers, 95.0 x 65.0 mm, 58 parts (29 on the bottom side), 58 nets.
