sladekdavid1-rgb/cnc-pendant-ugs-rp2040/01_DPS_KiCad/pendant_C_led/pendant_C_led.kicad_pcb

## KiCad design 01_DPS_KiCad/pendant_C_led/pendant_C_led.kicad_pcb (2026-10-19)

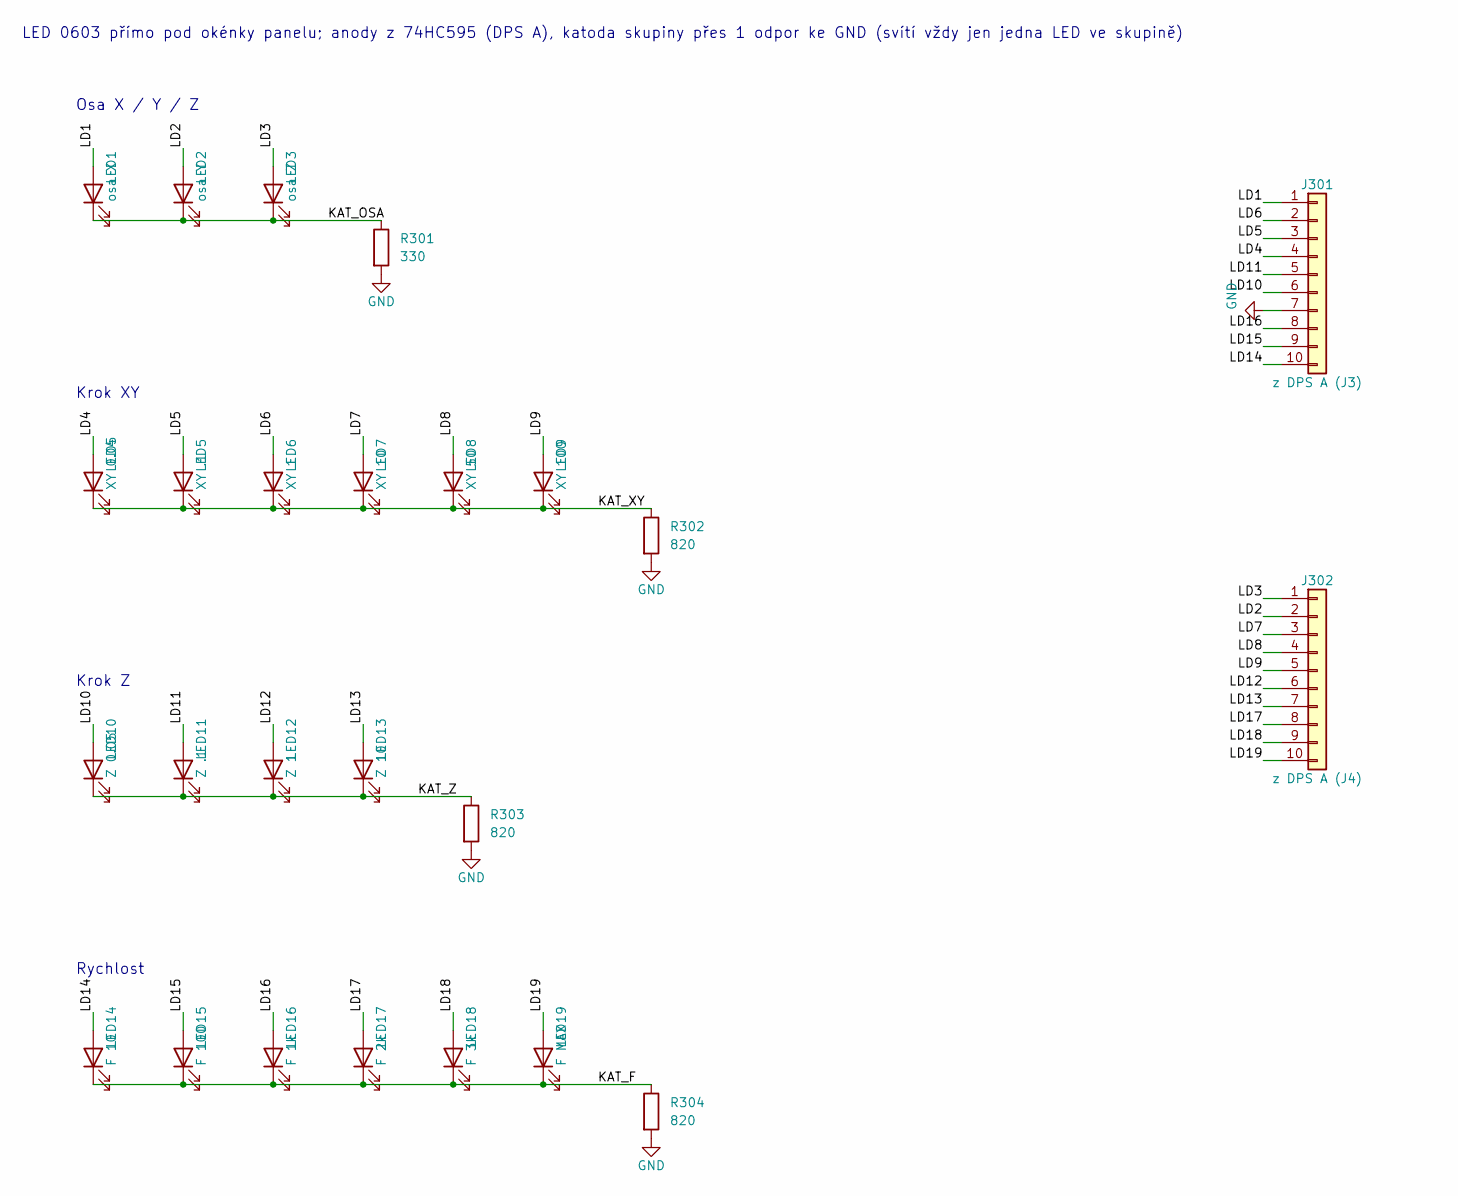
[picture p57: schematic pendant_C_led.kicad_sch, CNC pendant – LED DPS pod panelem (osy, krok XY, krok Z, ry…]

Parts:
J301: z DPS A (J3); PinHeader_1x12_P2.54mm_10pinu
J302: z DPS A (J4); PinHeader_1x10_P2.54mm_Vertical
LED1: osa X; LED_0603_1608Metric
LED2: osa Y; LED_0603_1608Metric
LED3: osa Z; LED_0603_1608Metric
LED4: XY 0.05; LED_0603_1608Metric
LED5: XY .1; LED_0603_1608Metric
LED6: XY 1; LED_0603_1608Metric
LED7: XY 10; LED_0603_1608Metric
LED8: XY 50; LED_0603_1608Metric
LED9: XY 100; LED_0603_1608Metric
LED10: Z 0.05; LED_0603_1608Metric
LED11: Z .1; LED_0603_1608Metric
LED12: Z 1; LED_0603_1608Metric
LED13: Z 10; LED_0603_1608Metric
LED14: F 10; LED_0603_1608Metric
LED15: F 100; LED_0603_1608Metric
LED16: F 1k; LED_0603_1608Metric
LED17: F 2k; LED_0603_1608Metric
LED18: F 3k; LED_0603_1608Metric
LED19: F MAX; LED_0603_1608Metric
R301: 330; R_0603_1608Metric
R302, R303, R304: 820; R_0603_1608Metric

Connections:
/KAT_F: LED14.1 (K), LED15.1 (K), LED16.1 (K), LED17.1 (K), LED18.1 (K), LED19.1 (K), R304.1
/KAT_OSA: LED1.1 (K), LED2.1 (K), LED3.1 (K), R301.1
/KAT_XY: LED4.1 (K), LED5.1 (K), LED6.1 (K), LED7.1 (K), LED8.1 (K), LED9.1 (K), R302.1
/KAT_Z: LED10.1 (K), LED11.1 (K), LED12.1 (K), LED13.1 (K), R303.1
/LD1: J301.1, LED1.2 (A)
/LD2: J302.2, LED2.2 (A)
/LD3: J302.1, LED3.2 (A)
/LD4: J301.4, LED4.2 (A)
/LD5: J301.3, LED5.2 (A)
/LD6: J301.2, LED6.2 (A)
/LD7: J302.3, LED7.2 (A)
/LD8: J302.4, LED8.2 (A)
/LD9: J302.5, LED9.2 (A)
/LD10: J301.6, LED10.2 (A)
/LD11: J301.5, LED11.2 (A)
/LD12: J302.6, LED12.2 (A)
/LD13: J302.7, LED13.2 (A)
/LD14: J301.10, LED14.2 (A)
/LD15: J301.9, LED15.2 (A)
/LD16: J301.8, LED16.2 (A)
/LD17: J302.8, LED17.2 (A)
/LD18: J302.9, LED18.2 (A)
/LD19: J302.10, LED19.2 (A)
GND: J301.7, R301.2, R302.2, R303.2, R304.2

Notes on the sheet:
LED 0603 přímo pod okénky panelu; anody z 74HC595 (DPS A), katoda skupiny přes 1 odpor ke GND (svítí vždy jen jedna LED ve skupině)
Osa X / Y / Z
Krok XY
Krok Z
Rychlost

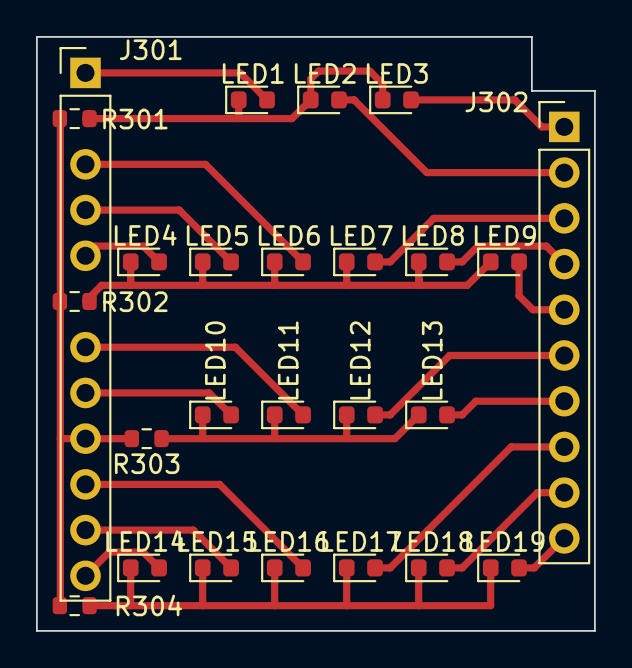
[picture p58: board pendant_C_led.kicad_pcb from above]

Board: 2 copper layers, 31.0 x 33.0 mm, 25 parts (0 on the bottom side), 24 nets.
