sladekdavid1-rgb/cnc-pendant-ugs-rp2040/(commit log)

2026-10-19 CNC pendant v1.0 – kompletní podklady
    KiCad projekty desek A/B/C, G-kódy pro frézování DPS, přípravek,
    panel (frézování + laser), krabička a díly pro 3D tisk, firmware
    (v11 + v10 + testy), zkratky pro UGS, soupiska a návod.
    Claude-Session: https://claude.ai/code/session_01WBfAEAiNPbQTp3BvhDgHF2
    [BOM_CNC_pendant.csv, CNCpendant.3mf, CNCpendant.step, distance.scad, distance_A-panel_3_5mm.stl, distance_B-A_11mm_SESTIHRAN_5_5.stl, distance_sada_5+5ks.stl, knoflik_D_osa_10mm_nad_panelem.stl]
2026-10-19 Kontrola DPS proti KiCadu, nové náhledy desek
    - náhledy mědi a rozmístění A/B/C vykreslené z aktuálních souborů KiCad
    (nahrazují staré obrázky routování z dřívější verze)
    - KONTROLA_DPS.md: schéma vs DPS, DRC, gerbery, simulace izolace,
    vrtání a ořezy – vše bez chyb
    - návod: seznam vývodů desky A, které se musí pájet i shora;
    SMD na desce A jsou na spodní straně; výsledky kontroly
    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
2026-10-19 Poznámka: odpory LED odladit podle použitých LED
    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
    [BOM_CNC_pendant.csv]
2026-10-19 v1.0: uzavření projektu, příprava na budoucí úpravy
    - STAV_PROJEKTU.md: stav, otevřené body, nápady, postup úprav
    - CHANGELOG.md
    - nastroje/: kontrola.py (schéma↔DPS, DRC, gerbery, simulace izolace,
    vrtání) a render.py (náhledy desek) přizpůsobené struktuře repozitáře
    - GitHub Actions: automatická kontrola DPS při změně podkladů
    - README: stav projektu a odkazy
    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
2026-10-19 Oprava: HOME, RTZ, PROBE a NULA fungují i bez zvolené osy
    Firmware v11.1 a v10.1: zvolená osa je potřeba jen pro pojezd
    (šipky, enkodér). Ostatní tlačítka reagují vždy. Ověřeno simulací.
    Upraven návod, README a CHANGELOG (v1.0.1).
    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
